estuariolabs/tolhuin-chord/pcb/out/connections.txt

TOLHUIN - lista de conexiones (generada automaticamente)
============================================================

3V3               : U7.VOUT+, U1.3V3, U2.VIN, U2.XSMT, U3.VDD, U4.VCC, U5.VCC, C1.1, C2.1, C3.1, C4.1, C5.1, C6.1, C7.1, R1.1, R2.1
GND               : U1.GND, U2.GND, U2.SCK, U2.FMT, U2.FLT, U2.DEMP, U3.GND, U3.ADDR, U4.GND, U5.GND, J1.SLEEVE, U6.OUT-, U7.VIN-, U7.VOUT-, C1.2, C2.2, C3.2, C4.2, C5.2, C6.2, C7.2, SW1.B, SW2.B, SW3.B, SW4.B, SW5.B, SW6.B, SW7.B, SW8.B, SW9.B, SW10.B, SW11.B
BAT_P             : BT1.+, U6.BAT+
BAT_N             : BT1.-, U6.BAT-
VSYS              : U6.OUT+, SW12.1
VSYS_SW           : SW12.2, U7.VIN+
I2S_BCK           : U1.GPIO38, U2.BCK
I2S_WS            : U1.GPIO39, U2.LCK
I2S_DIN           : U1.GPIO40, U2.DIN
I2C_SDA           : U1.GPIO41, U3.SDA, U4.SDA, R1.2
I2C_SCL           : U1.GPIO42, U3.SCL, U4.SCL, R2.2
AUDIO_L           : U2.LOUT, J1.TIP
AUDIO_R           : U2.ROUT, J1.RING
JOY_VRX           : U3.A0, U5.VRX
JOY_VRY           : U3.A1, U5.VRY
JOY_SW            : U1.GPIO13, U5.SW
BTN_I_GPIO15      : U1.GPIO15, SW1.A
BTN_II_GPIO16     : U1.GPIO16, SW2.A
BTN_III_GPIO17    : U1.GPIO17, SW3.A
BTN_IV_GPIO18     : U1.GPIO18, SW4.A
BTN_V_GPIO21      : U1.GPIO21, SW5.A
BTN_VI_GPIO47     : U1.GPIO47, SW6.A
BTN_VII_GPIO48    : U1.GPIO48, SW7.A
NAV_MINUS_GPIO11  : U1.GPIO11, SW8.A
NAV_PLUS_GPIO12   : U1.GPIO12, SW9.A
HOLD_GPIO14       : U1.GPIO14, SW10.A
VOICING_GPIO7     : U1.GPIO7, SW11.A
