estuariolabs/tolhuin-chord/icons.h

/* ============================================================================
   icons.h  -  Pixel-art del OLED (GENERADO por tools/gen_icons.py: el arte
   se edita ALLA como grillas ASCII, NO aca). Formato drawBitmap (MSB first).
   Estados 10x10 (fila 0) + paginas del menu 12x12 (junto al titulo).
   ============================================================================ */
#pragma once
#include <stdint.h>

#define IC_STATE_W 10
#define IC_STATE_H 10
#define IC_PAGE_W  12
#define IC_PAGE_H  12

static const uint8_t IC_STATE_HOLD[] = { 0x1E, 0x00, 0x21, 0x00, 0x21, 0x00, 0x7F, 0x80, 0x7F, 0x80, 0x73, 0x80, 0x73, 0x80, 0x7F, 0x80, 0x7F, 0x80, 0x00, 0x00 };
static const uint8_t IC_STATE_GLIDE[] = { 0xC0, 0x00, 0xE0, 0x00, 0x70, 0x00, 0x38, 0x00, 0x1C, 0x00, 0x0E, 0x00, 0x07, 0x00, 0x03, 0x80, 0x01, 0xC0, 0x00, 0xC0 };
static const uint8_t IC_STATE_MONO[] = { 0x00, 0x00, 0x0C, 0x00, 0x1C, 0x00, 0x3C, 0x00, 0x0C, 0x00, 0x0C, 0x00, 0x0C, 0x00, 0x0C, 0x00, 0x3F, 0x00, 0x00, 0x00 };
static const uint8_t IC_STATE_ARP[] = { 0x00, 0xC0, 0x00, 0xC0, 0x07, 0xC0, 0x06, 0x00, 0x06, 0x00, 0x3E, 0x00, 0x30, 0x00, 0xF8, 0x00, 0xC0, 0x00, 0xC0, 0x00 };
static const uint8_t IC_STATE_SUSTAIN[] = { 0x00, 0x00, 0x1E, 0x00, 0x21, 0x00, 0x40, 0x80, 0x80, 0x40, 0x00, 0x00, 0x0C, 0x00, 0x0C, 0x00, 0x00, 0x00, 0x00, 0x00 };
static const uint8_t IC_STATE_TREMOLO[] = { 0x00, 0x00, 0x63, 0x00, 0x94, 0x80, 0x08, 0x40, 0x00, 0x00, 0x63, 0x00, 0x94, 0x80, 0x08, 0x40, 0x00, 0x00, 0x00, 0x00 };
static const uint8_t IC_STATE_CHORUS[] = { 0x00, 0x00, 0x70, 0x00, 0x88, 0x00, 0x9C, 0x00, 0x92, 0x00, 0x72, 0x00, 0x12, 0x00, 0x1E, 0x00, 0x00, 0x00, 0x00, 0x00 };
static const uint8_t IC_STATE_BODY[] = { 0x00, 0x00, 0x1E, 0x00, 0x3F, 0x00, 0x7F, 0x80, 0x6D, 0x80, 0x7F, 0x80, 0x6D, 0x80, 0x3F, 0x00, 0x1E, 0x00, 0x00, 0x00 };
static const uint8_t IC_STATE_DRUMS[] = { 0x00, 0x00, 0x3F, 0x00, 0x40, 0x80, 0x7F, 0x80, 0x40, 0x80, 0x40, 0x80, 0x40, 0x80, 0x3F, 0x00, 0x12, 0x00, 0x00, 0x00 };
static const uint8_t IC_STATE_REC[] = { 0x00, 0x00, 0x1E, 0x00, 0x3F, 0x00, 0x7F, 0x80, 0x7F, 0x80, 0x7F, 0x80, 0x7F, 0x80, 0x3F, 0x00, 0x1E, 0x00, 0x00, 0x00 };
static const uint8_t IC_STATE_LOOP[] = { 0x00, 0x00, 0x30, 0x00, 0x3C, 0x00, 0x3F, 0x00, 0x3F, 0x80, 0x3F, 0x00, 0x3C, 0x00, 0x30, 0x00, 0x00, 0x00, 0x00, 0x00 };

// Tabla indexada (orden = enum en este header).
static const uint8_t* const IC_STATE[] = {
  IC_STATE_HOLD, IC_STATE_GLIDE, IC_STATE_MONO, IC_STATE_ARP, IC_STATE_SUSTAIN, IC_STATE_TREMOLO, IC_STATE_CHORUS, IC_STATE_BODY, IC_STATE_DRUMS, IC_STATE_REC, IC_STATE_LOOP
};

enum IconState { ICS_HOLD, ICS_GLIDE, ICS_MONO, ICS_ARP, ICS_SUSTAIN, ICS_TREMOLO, ICS_CHORUS, ICS_BODY, ICS_DRUMS, ICS_REC, ICS_LOOP };

static const uint8_t IC_PAGE_SONIDO[] = { 0x00, 0x00, 0x07, 0xE0, 0x07, 0xE0, 0x06, 0x20, 0x06, 0x00, 0x06, 0x00, 0x06, 0x00, 0x06, 0x00, 0x3F, 0x00, 0x7F, 0x80, 0x3F, 0x00, 0x00, 0x00 };
static const uint8_t IC_PAGE_ARMONIA[] = { 0x00, 0x00, 0x3F, 0xF0, 0x3F, 0xF0, 0x30, 0x30, 0x30, 0x30, 0x30, 0x30, 0x30, 0x30, 0x30, 0x30, 0xF0, 0xF0, 0xF0, 0xF0, 0x00, 0x00, 0x00, 0x00 };
static const uint8_t IC_PAGE_JOYSTICK[] = { 0x00, 0x00, 0x06, 0x00, 0x0F, 0x00, 0x0F, 0x00, 0x06, 0x00, 0x06, 0x00, 0x06, 0x00, 0x0F, 0x00, 0x7F, 0xE0, 0xFF, 0xF0, 0x00, 0x00, 0x00, 0x00 };
static const uint8_t IC_PAGE_RITMO[] = { 0x00, 0x00, 0x7F, 0xE0, 0x80, 0x10, 0xFF, 0xF0, 0x80, 0x10, 0x80, 0x10, 0x80, 0x10, 0x80, 0x10, 0x7F, 0xE0, 0x10, 0x80, 0x20, 0x40, 0x00, 0x00 };
static const uint8_t IC_PAGE_ARP[] = { 0x00, 0x30, 0x00, 0x30, 0x01, 0xF0, 0x01, 0x80, 0x01, 0x80, 0x0F, 0x80, 0x0C, 0x00, 0x0C, 0x00, 0x7C, 0x00, 0x60, 0x00, 0x60, 0x00, 0x00, 0x00 };
static const uint8_t IC_PAGE_LOOPER[] = { 0x00, 0x00, 0x1F, 0x00, 0x20, 0x80, 0x40, 0x40, 0x40, 0x40, 0x41, 0xF0, 0x40, 0xE0, 0x40, 0x40, 0x20, 0x80, 0x1F, 0x00, 0x00, 0x00, 0x00, 0x00 };
static const uint8_t IC_PAGE_CANAL[] = { 0x00, 0x00, 0x0F, 0xE0, 0x0F, 0xE0, 0x00, 0x00, 0x80, 0x00, 0xCF, 0xE0, 0xEF, 0xE0, 0xCF, 0xE0, 0x80, 0x00, 0x00, 0x00, 0x0F, 0xE0, 0x0F, 0xE0 };
static const uint8_t IC_PAGE_TOQUE[] = { 0x00, 0x00, 0x15, 0x00, 0x15, 0x00, 0x15, 0x00, 0x1F, 0x00, 0x3F, 0x00, 0x7F, 0x00, 0x7F, 0x00, 0x7F, 0x00, 0x3F, 0x00, 0x1E, 0x00, 0x00, 0x00 };
static const uint8_t IC_PAGE_AMBIENTE[] = { 0x00, 0x00, 0x60, 0x00, 0x60, 0x00, 0x66, 0x00, 0x66, 0x00, 0x66, 0x60, 0x66, 0x60, 0x66, 0x60, 0x66, 0x60, 0x00, 0x00, 0x00, 0x00, 0x00, 0x00 };
static const uint8_t IC_PAGE_SYNC[] = { 0x00, 0x00, 0x1F, 0x80, 0x20, 0x40, 0x42, 0x20, 0x42, 0x20, 0x82, 0x10, 0x83, 0xD0, 0x80, 0x10, 0x40, 0x20, 0x40, 0x20, 0x20, 0x40, 0x1F, 0x80 };
static const uint8_t IC_PAGE_MEMORIA[] = { 0x00, 0x00, 0x7F, 0xC0, 0x40, 0x60, 0x4F, 0x20, 0x4F, 0x20, 0x40, 0x20, 0x4F, 0x20, 0x50, 0xA0, 0x50, 0xA0, 0x50, 0xA0, 0x7F, 0xE0, 0x00, 0x00 };

// Tabla indexada (orden = enum en este header).
static const uint8_t* const IC_PAGE[] = {
  IC_PAGE_SONIDO, IC_PAGE_ARMONIA, IC_PAGE_JOYSTICK, IC_PAGE_RITMO, IC_PAGE_ARP, IC_PAGE_LOOPER, IC_PAGE_CANAL, IC_PAGE_TOQUE, IC_PAGE_AMBIENTE, IC_PAGE_SYNC, IC_PAGE_MEMORIA
};

// Orden = FX_PAGES del .ino (indice de pagina -> icono).
enum IconPage { ICP_SONIDO, ICP_ARMONIA, ICP_JOYSTICK, ICP_RITMO, ICP_ARP, ICP_LOOPER, ICP_CANAL, ICP_TOQUE, ICP_AMBIENTE, ICP_SYNC, ICP_MEMORIA };
