estuariolabs/tolhuin-chord/boot_zoom.h

/* ============================================================================
   boot_zoom.h  -  Frames del zoom de arranque (GENERADO por tools/gen_boot_zoom.py,
   NO editar a mano). 9 bitmaps 128x64 MONO_HLSB: Argentina completa (con Malvinas)
   -> Patagonia -> isla de Tierra del Fuego. Rombo de Tolhuin en los frames 6..8.
   Se muestran a 333 ms por frame = 3 s (3 zooms por segundo). Solo lo incluye
   oled.cpp (despues de Arduino.h, que define PROGMEM).
   ============================================================================ */
#pragma once

static const uint8_t ZOOM[9][1024] PROGMEM = {
  { // frame 0
    0,0,0,0,0,0,0,0,0,0,0,0,0,0,0,0,0,0,0,0,
    0,0,0,0,0,0,0,0,0,0,0,0,0,0,0,0,0,0,0,15,
    224,0,0,0,0,0,0,0,0,0,0,0,0,0,0,8,16,0,0,0,
    0,0,0,0,0,0,0,0,0,0,0,8,8,0,0,0,0,0,0,0,
    0,0,0,0,0,0,0,8,8,0,0,0,0,0,0,0,0,0,0,0,
    0,0,0,8,6,0,0,0,0,0,0,0,0,0,0,0,0,0,0,16,
    1,128,0,0,0,0,0,0,0,0,0,0,0,0,0,16,0,64,0,0,
    0,0,0,0,0,0,0,0,0,0,0,16,0,60,0,0,0,0,0,0,
    0,0,0,0,0,0,0,32,0,2,0,0,0,0,0,0,0,0,0,0,
    0,0,0,32,0,4,0,0,0,0,0,0,0,0,0,0,0,0,0,64,
    0,8,0,0,0,0,0,0,0,0,0,0,0,0,0,64,0,16,0,0,
    0,0,0,0,0,0,0,0,0,0,0,64,0,32,0,0,0,0,0,0,
    0,0,0,0,0,0,0,128,0,32,0,0,0,0,0,0,0,0,0,0,
    0,0,0,128,0,64,0,0,0,0,0,0,0,0,0,0,0,0,0,128,
    0,128,0,0,0,0,0,0,0,0,0,0,0,0,1,0,0,128,0,0,
    0,0,0,0,0,0,0,0,0,0,1,0,0,128,0,0,0,0,0,0,
    0,0,0,0,0,0,1,0,0,128,0,0,0,0,0,0,0,0,0,0,
    0,0,1,0,0,128,0,0,0,0,0,0,0,0,0,0,0,0,0,128,
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
    0,0,0,0,8,0,0,192,0,0,3,0,0,0,0,0,0,0,0,0,
    28,0,0,48,0,0,0,192,0,0,0,0,0,0,0,0,62,0,0,12,
    0,0,0,48,0,0,0,0,0,0,0,0,127,0,0,3,0,0,0,14,
    0,0,0,0,0,0,0,0,62,0,0,0,0,0,0,1,192,0,0,0,
    0,0,0,0,28,0,0,1,0,0,0,0,56,0,0,0,0,0,0,0,
    8,0,0,6,0,0,0,0,7,0,0,0,0,0,0,0,0,0,0,24,
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
  },
};
