estuariolabs/tolhuin-chord/drum_samples.h

/* ============================================================================
   drum_samples.h  -  Samples de bateria (GENERADO por tools/gen_drum_samples.py
   desde tools/samples/*.wav, NO editar a mano). PCM int16 mono; en el ESP32
   los const van a flash (~28 KB). Lo incluye SOLO dsp.cpp.
   ============================================================================ */
#pragma once
#include <stdint.h>

#define DS_RATE 22050u   // sample rate de los WAV de origen

static const uint32_t DS_KICK_LEN = 6615u;
static const int16_t  DS_KICK[6615] = {
  12,422,1106,1702,2069,2885,4277,5254,5210,7915,11460,13558,17411,22025,24554,26233,27977,29799,30957,30976,
  30965,30996,30943,31024,30897,31061,27043,20487,22522,29707,29404,13376,-4814,-14070,-13742,-8873,1575,10081,14605,19371,
  14340,2708,-7288,-7330,-2379,-1028,-4067,-5835,-2090,1079,583,-9330,-18625,-22647,-21664,-17109,-15741,-17168,-20138,-20597,
  -16403,-16681,-20725,-22958,-27577,-30130,-30694,-31072,-30366,-26348,-22625,-24330,-29776,-31129,-30895,-31034,-30928,-31017,-30938,-31008,
  -30946,-31003,-30952,-30997,-30956,-30993,-30961,-30988,-30964,-30986,-30966,-30983,-30968,-30982,-30969,-30981,-30970,-30980,-30972,-30978,
  -30976,-30972,-30982,-30964,-30993,-30951,-31012,-30920,-31084,-30039,-23920,-21511,-28067,-30982,-30757,-27538,-27424,-24882,-22734,-21152,
  -17103,-15918,-13571,-13668,-9262,-8312,-9487,-6161,-2278,2150,3463,2686,5946,8546,9268,11428,13110,14812,14318,14197,
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
  6088,-3639,2665,11096,-7301,7757,1936,8798,134,-1892,-6232,4752,-3355,-7880,785,-573,-4218,-22,-1491,-5431,
  6422,-10128,-2248,529,-3745,-6110,3762,434,-3979,-4324,8202,-4986,-7857,8158,-6672,2677,-4173,-4046,9966,-10061,
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
};
