estuariolabs/tolhuin-chord/(commit log)

2026-08-01 TOLHUIN Chord: firmware ESP32-S3 + motor + hardware + herramientas (GPL-3.0)
    Sinte de acordes diatónicos con motor de audio propio. Snapshot limpio de v2
    (sin binarios de firmware ni artefactos de build). Incluye:
    - Motor host-compilable: dsp / harmony / evloop (+ tests que pasan en host)
    - Firmware: synth (I2S+FreeRTOS), input (ADS1115), midi (USB+BLE), oled, webcfg
    - webtool (flasheo web) + tools (samples propios, generadores, render) + pcb + diags
    - Docs de desarrollo (CLAUDE.md, TASKS.md)
    Motor puro como repo aparte: github.com/radarapdadmin-netizen/tolhuin-chord-engine
2026-10-03 case: carcasa v3 para ESP32-S3 DevKit completa, sin hot-glue
    Switches MX encastrados en el panel, OLED y joystick en rieles con
    ranura, perfboard atornillada, guias para TP4056/buck-boost, bahia de
    bateria y tornillos M3 ocultos desde abajo. Medidas reales: DevKit
    63x27, joystick 33x26 y 13 mm de alto. Chequeos de choque con assert.
    Claude-Session: https://claude.ai/code/session_01M7YiCRMbKqNeP9v4nTQa44
2026-10-03 case: paletas de color, teclas por funcion armonica y grabados del panel
    - theme: 6 paletas (bosque, glaciar, noche, lenga, mar, clasico)
    - chord_color=funcion: grados en 3 tonos T/S/D + partes caps_T/S/D
    - leyendas separadas del cuerpo (render en color; cambio de filamento)
    - deco: marco OLED, aro joystick y linea funcion/acordes grabados
    - chaflan superior 1.6 mm y leyendas un poco mas chicas
    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
2026-10-03 case: inclinacion de 7 grados con cuna bajo el piso
    El interior no cambia (mismas alturas y chequeos). La base se exporta
    apoyada sobre la cara inclinada; patitas y URL pasan a esa cara y el
    alojamiento de los tornillos atraviesa la cuna. tilt=0 vuelve a plano.
    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
2026-10-03 case: ergonomia con frente biselado; cuna desactivada
    - front_bevel [8,12]: borde frontal en diagonal (muneca a 23 mm con MX,
    18 mm con Choc); pared inclinada en la base y columnas delanteras
    corridas hacia atras
    - tilt = 0 por defecto (sigue como opcion)
    - filas de teclas y joystick 2 mm hacia atras; parantes de perfboard 3 mm
    - part=clash para verificar que panel y base no se pisan
    - leyendas Choc sin espejar; render() en el ensamblado
    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
2026-10-03 case: OLED verificado; entra por la derecha y traba bien
    - Controles oled_fit / oled_path (montado y recorrido de insercion)
    - Por la izquierda chocaba con la pestana del panel: ahora entra por +X
    - El resalte de traba quedaba debajo de la placa montada: pasa a una
    prolongacion del riel, afuera de la placa (aplica tambien al joystick)
    - Guia: OLED antes que los switches, cables por detras
    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
2026-10-04 case: opcion conceptual de pantalla TFT 1.54" 240x240 (display="tft154")
    Ventana 28.6 mm, marco de ubicacion bajo el panel y mock de UI para el
    render. Medidas del modulo marcadas MEDIR; retencion final pendiente del
    modulo real. Default sin cambios (OLED 0.96"). part=tft_fit da vacio.
    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
